TiagoTavares005/LCLP_DLog/README.md

# LCLP_DLog
Low Cost Low Power DataLogger
