TiagoTavares005/LCLP_DLog/PCB/Readme

Existem duas versões da PCB: Versão V7 que foi a usada como prova de conceito e a Versão revisionada já com os componentes corrigidos para fazer a produção
