TiagoTavares005/LCLP_DLog/firmware_datalogger_estudos/estudo_huffman/grafico_dispersao_pulsos.png

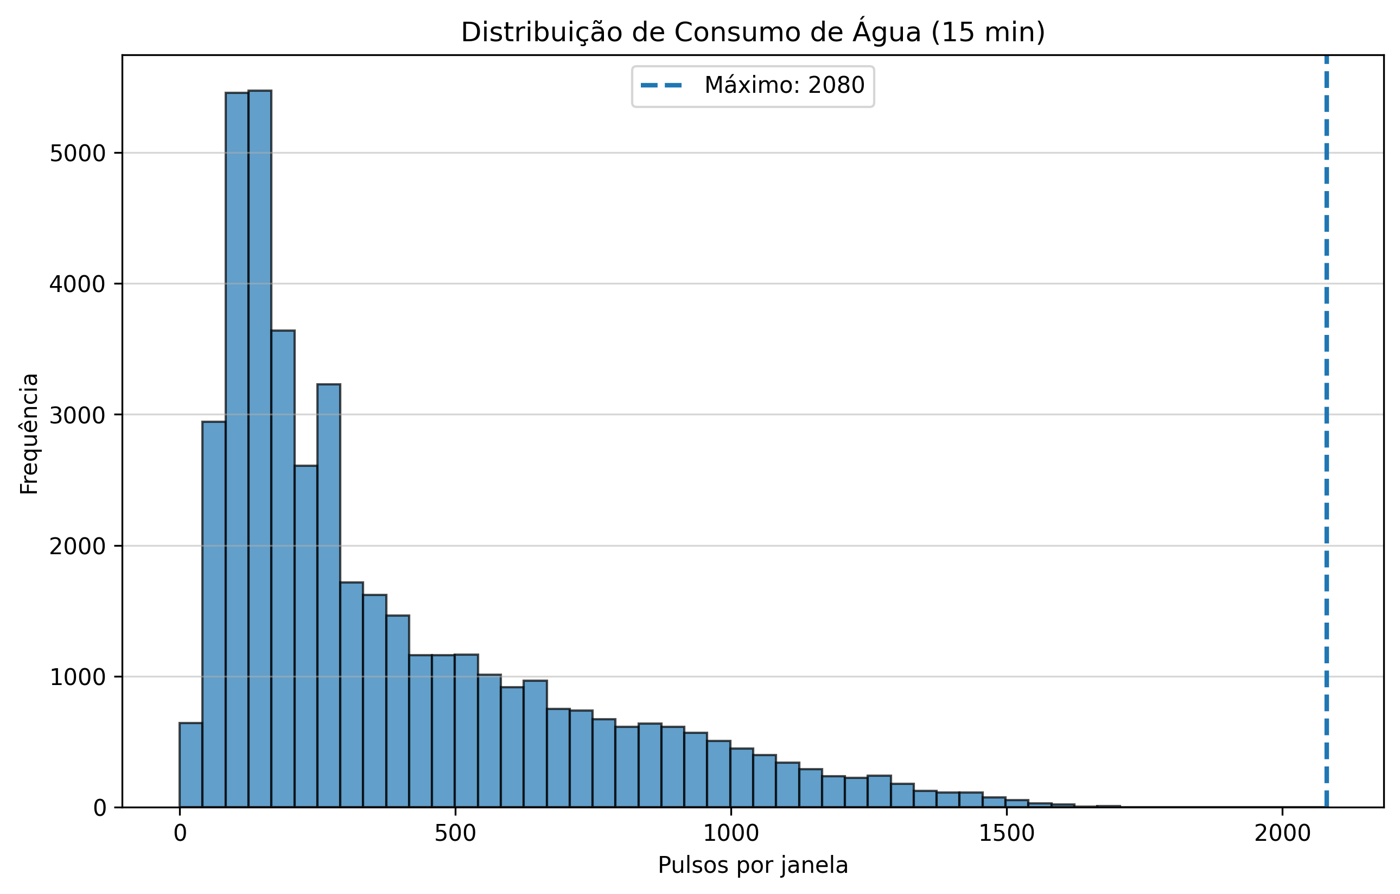
firmware_datalogger_estudos/estudo_huffman/grafico_dispersao_pulsos.png
