TiagoTavares005/LCLP_DLog/firmware_datalogger_estudos/estudo_sampls_ppk2/Analise_pulsos_datalogger/fig1_serie_temporal.png

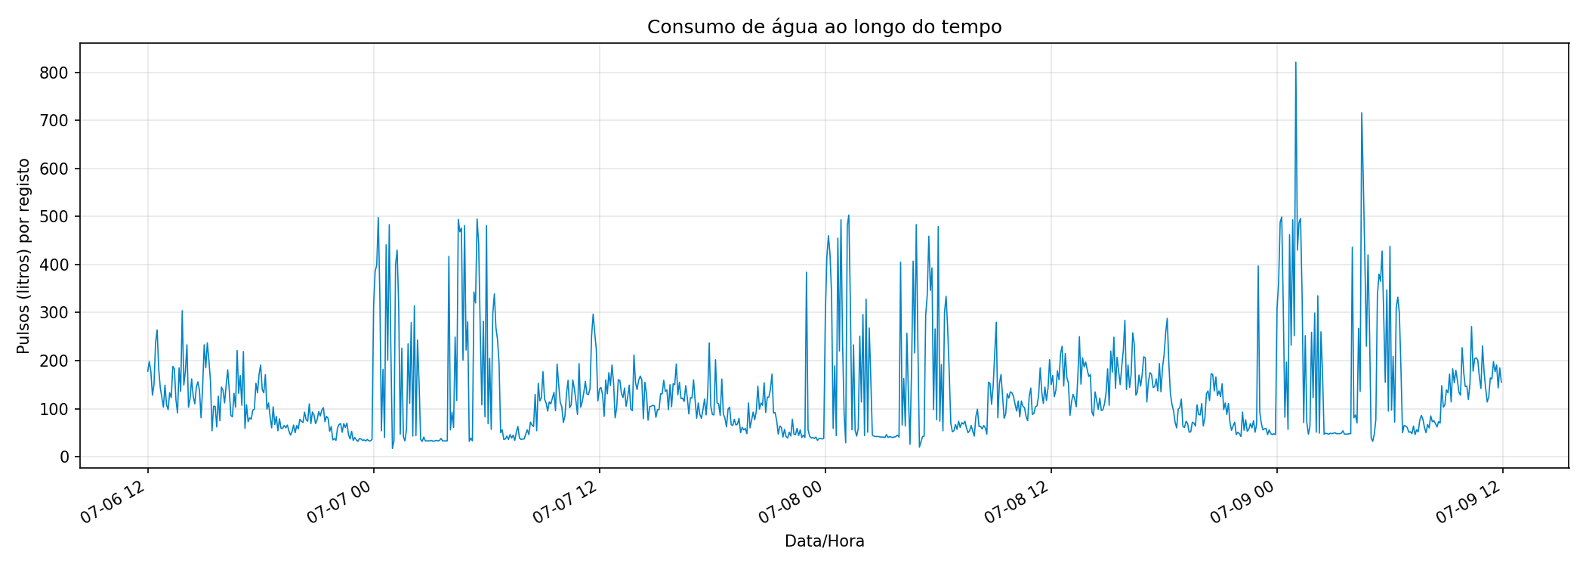
firmware_datalogger_estudos/estudo_sampls_ppk2/Analise_pulsos_datalogger/fig1_serie_temporal.png
