TiagoTavares005/LCLP_DLog/firmware_datalogger_estudos/estudo_sampls_ppk2/estudos_base_reais/consumos_1ksamp_2h10_sd1h_lora_2h_pcb/real_fig4_carga_acumulada.png

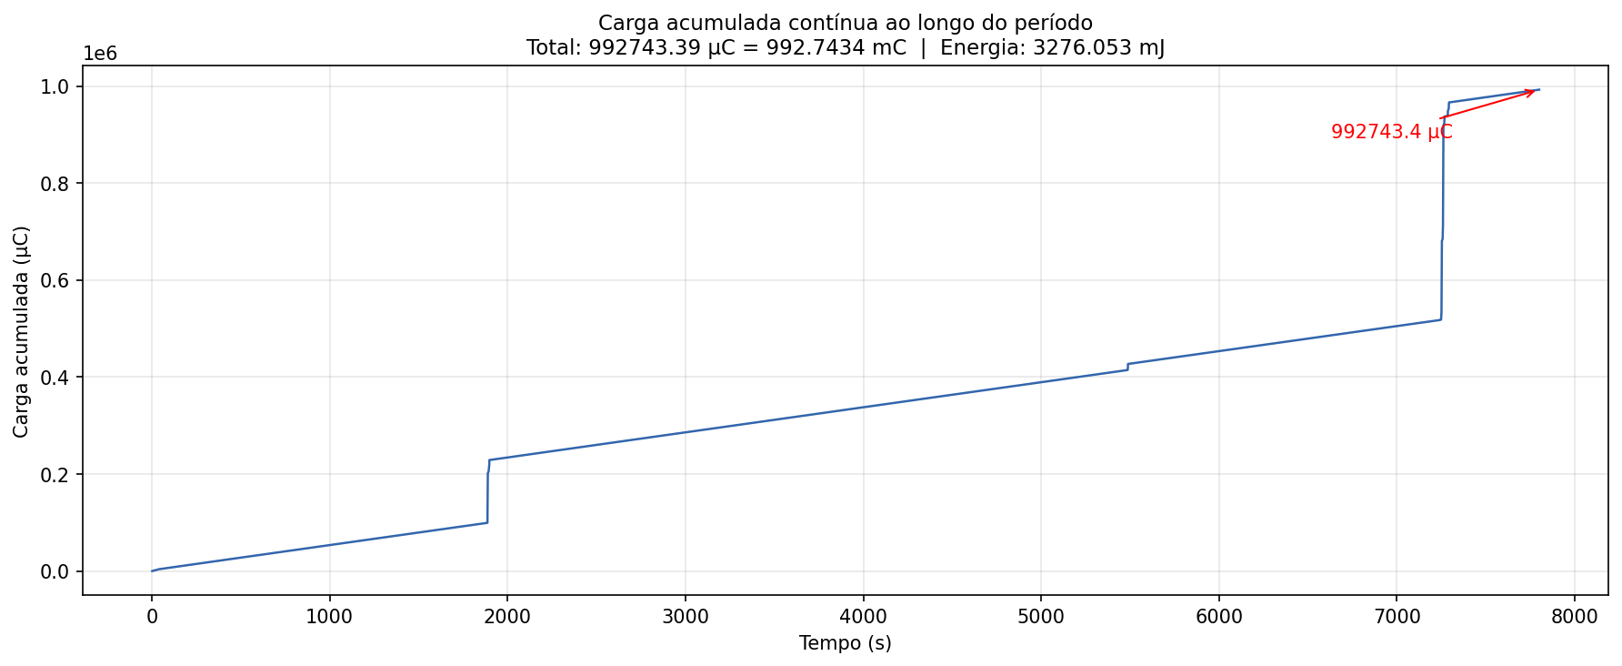
firmware_datalogger_estudos/estudo_sampls_ppk2/estudos_base_reais/consumos_1ksamp_2h10_sd1h_lora_2h_pcb/real_fig4_carga_acumulada.png
