TiagoTavares005/LCLP_DLog/firmware_datalogger_estudos/estudo_sampls_ppk2/fig1_overview_corrente.png

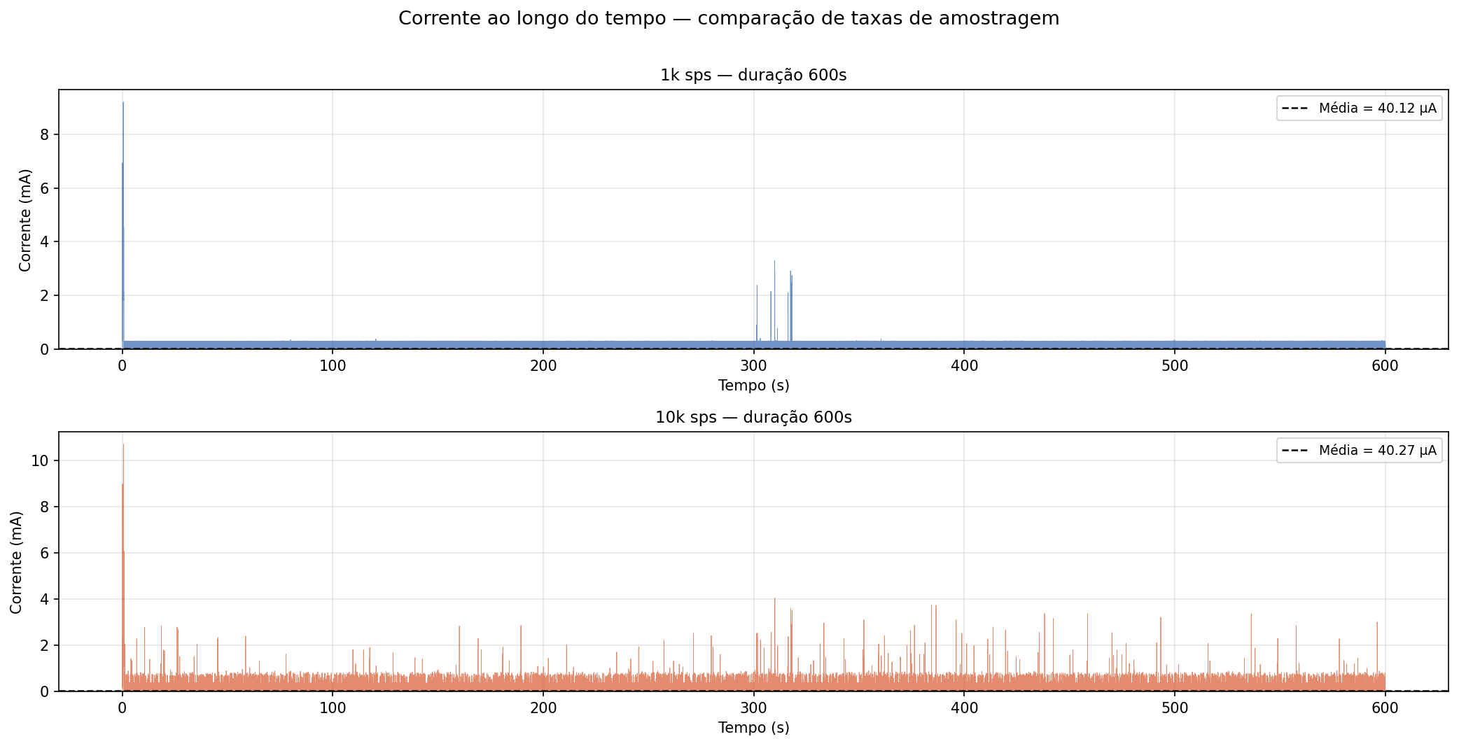
firmware_datalogger_estudos/estudo_sampls_ppk2/fig1_overview_corrente.png
