TiagoTavares005/LCLP_DLog/firmware_datalogger_estudos/estudo_sampls_ppk2/fig2_distribuicao.png

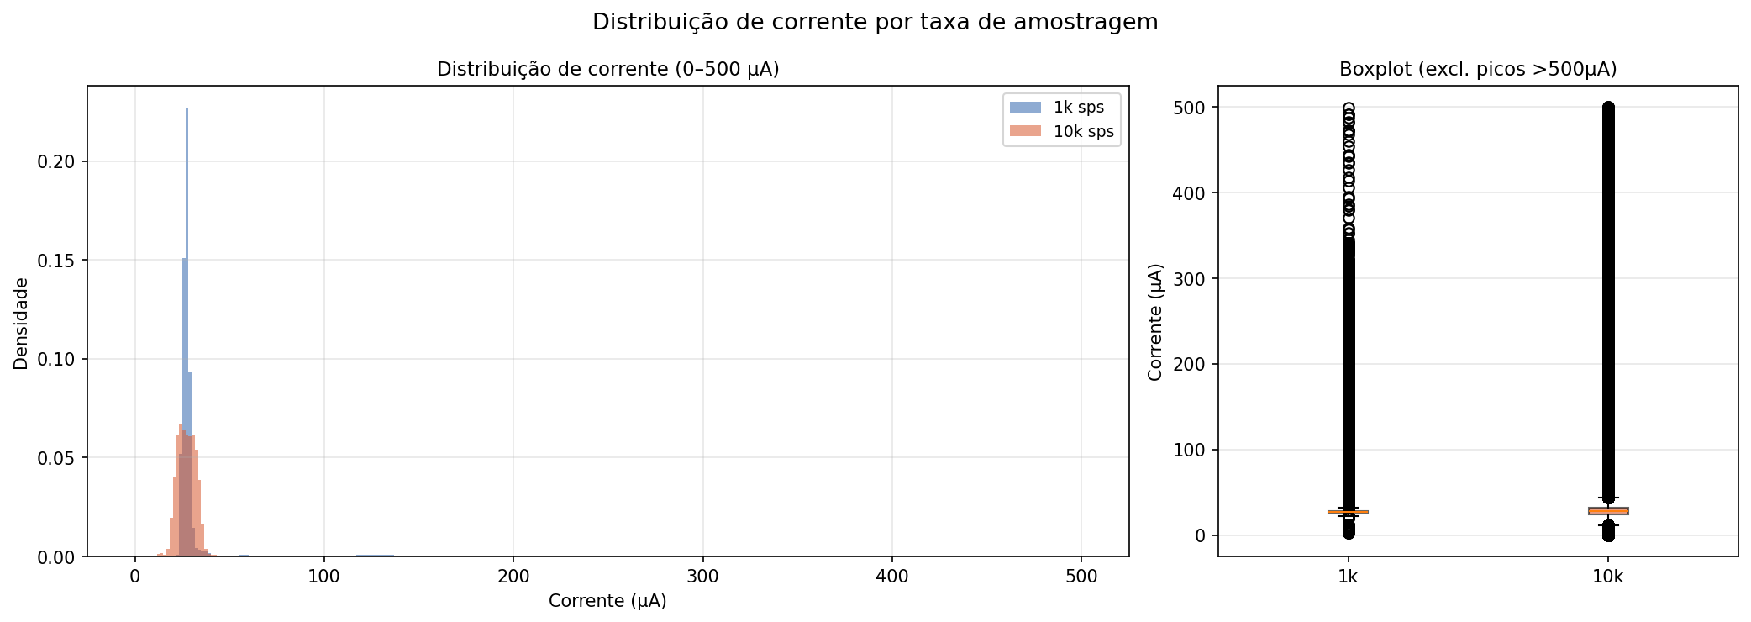
firmware_datalogger_estudos/estudo_sampls_ppk2/fig2_distribuicao.png
