TiagoTavares005/LCLP_DLog/firmware_datalogger_estudos/estudo_sampls_ppk2/fig3_zoom_pico.png

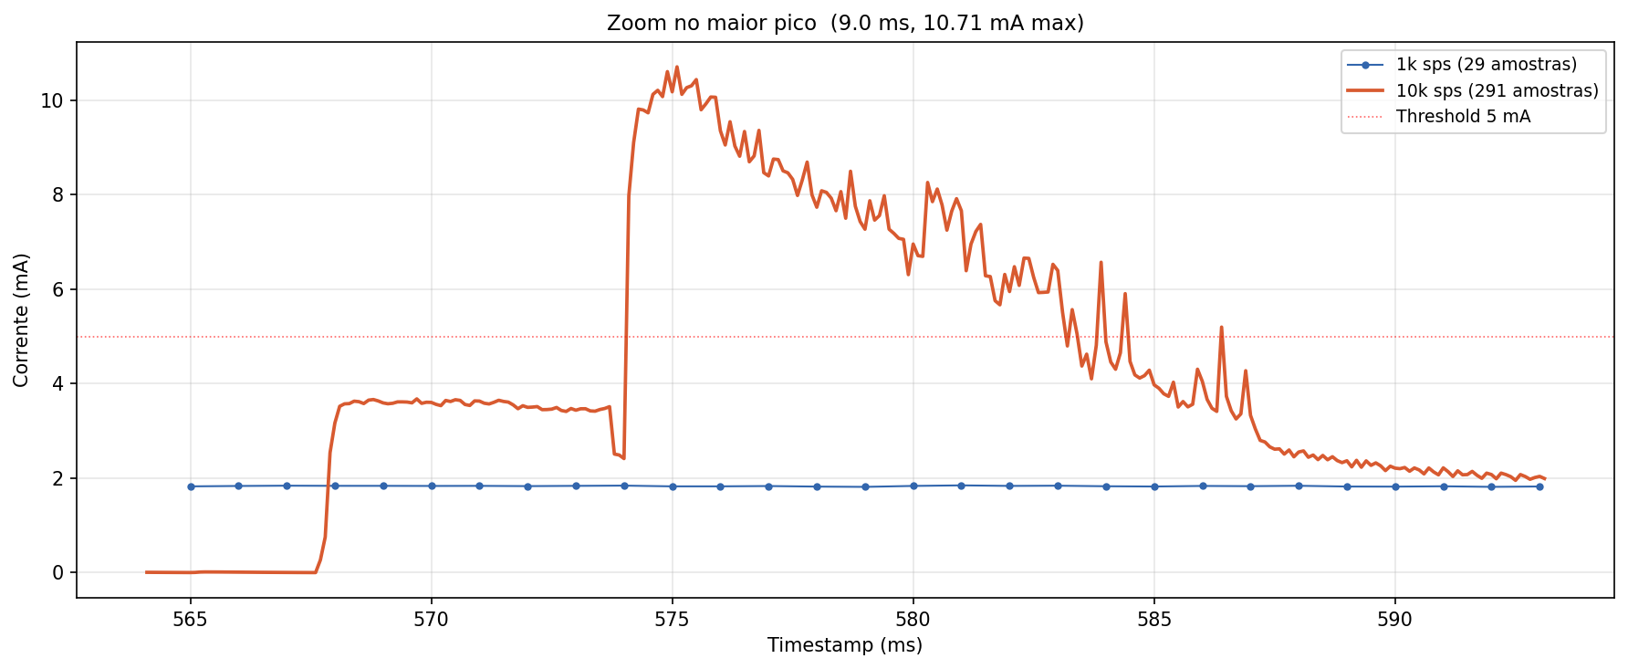
firmware_datalogger_estudos/estudo_sampls_ppk2/fig3_zoom_pico.png
