TiagoTavares005/LCLP_DLog/firmware_datalogger_estudos/estudo_sampls_ppk2/proj_fig2_decomposicao_energia.png

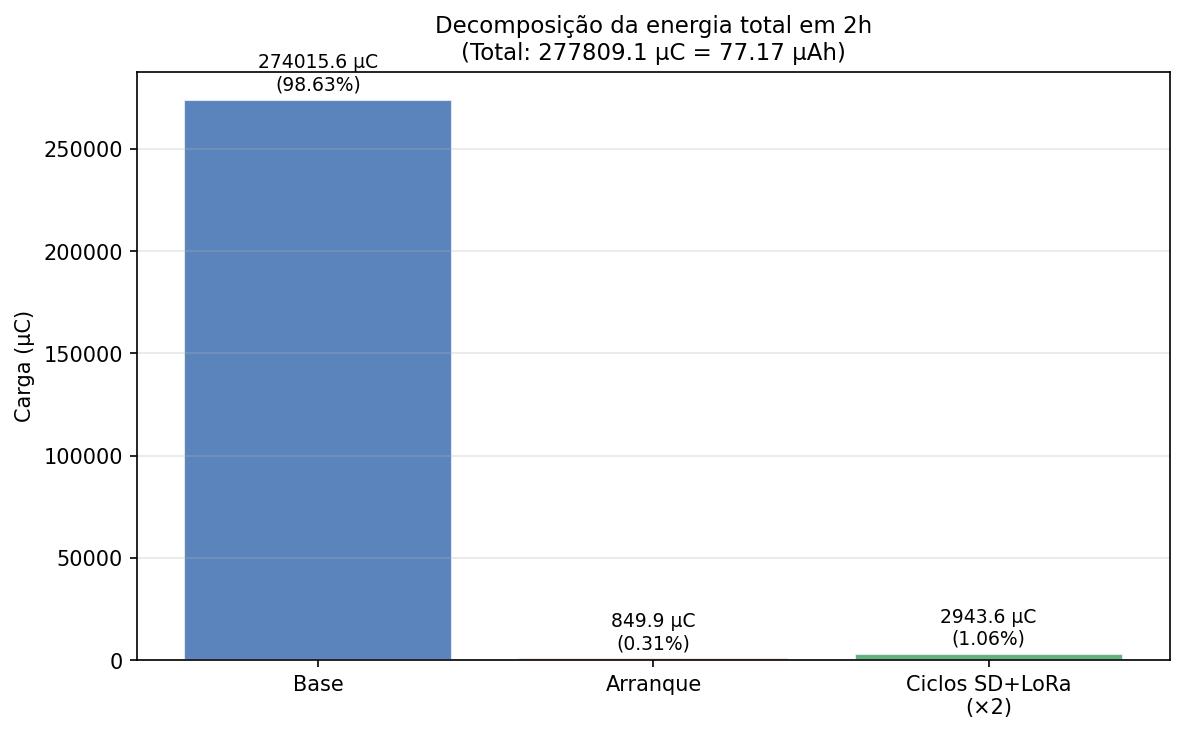
firmware_datalogger_estudos/estudo_sampls_ppk2/proj_fig2_decomposicao_energia.png
