TiagoTavares005/LCLP_DLog/firmware_datalogger_estudos/estudo_sampls_ppk2/proj_fig4_zoom_evento_sdlora.png

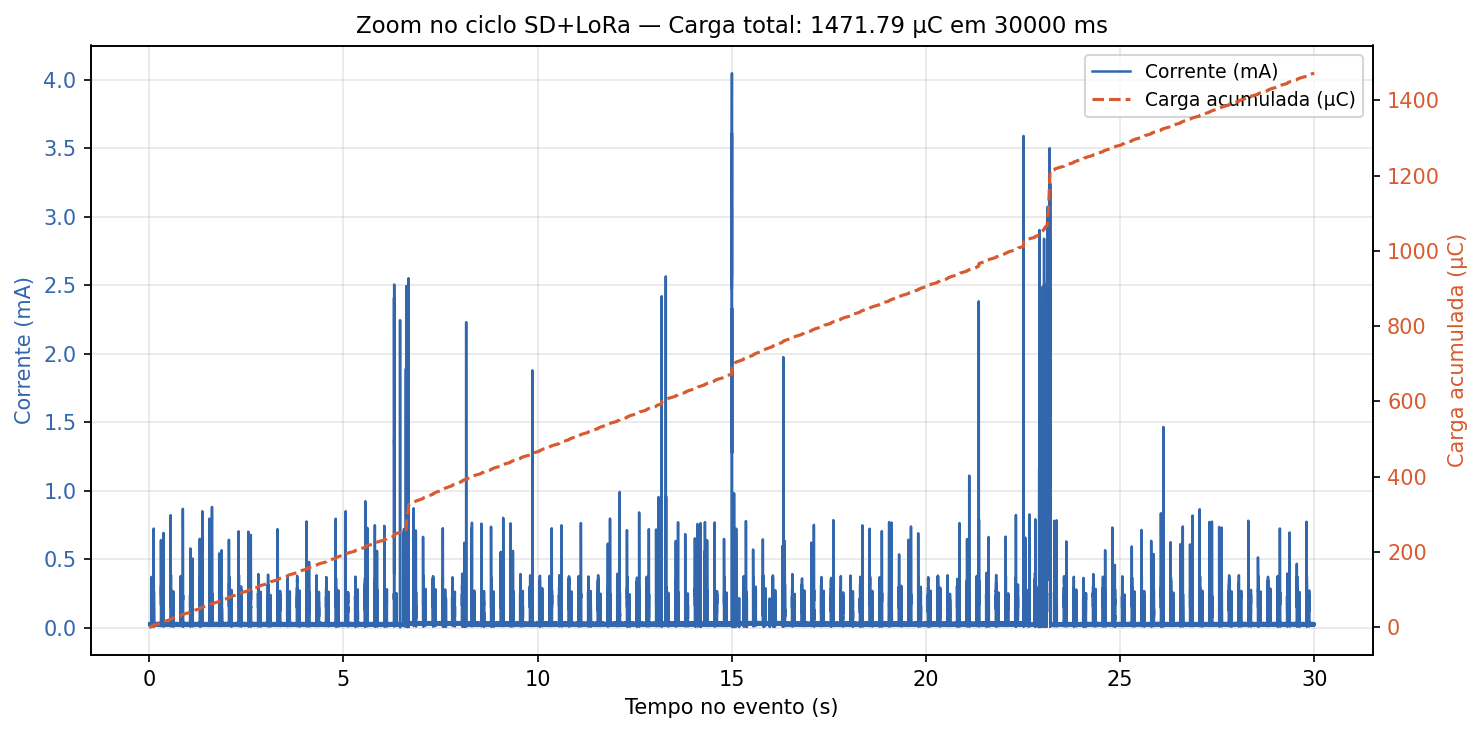
firmware_datalogger_estudos/estudo_sampls_ppk2/proj_fig4_zoom_evento_sdlora.png
