TiagoTavares005/LCLP_DLog/firmware_datalogger_estudos/estudo_sampls_ppk2/proj_fig1_perfil_componentes.png

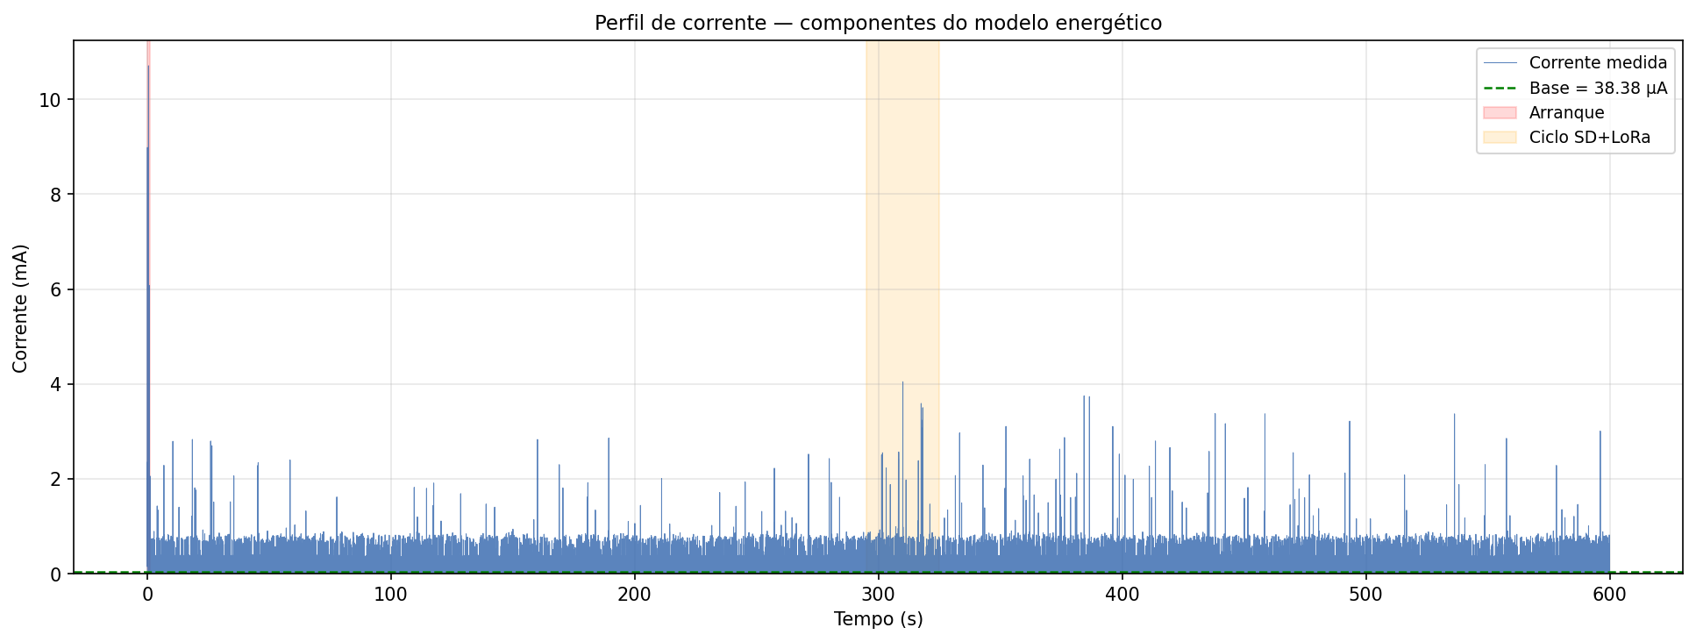
firmware_datalogger_estudos/estudo_sampls_ppk2/proj_fig1_perfil_componentes.png
