TiagoTavares005/LCLP_DLog/Firmware_LCLP/LCLP_Code/build/LCLP_Code_sysbuild_cache.txt

APPLICATION_BINARY_DIR:PATH=C:/Nordic/LCLP_Code/build
APPLICATION_SOURCE_DIR:PATH=C:/ncs/v3.1.1/zephyr/share/sysbuild/template
APP_DIR:PATH=c:/Nordic/LCLP_Code
BOARD_DIR:PATH=C:/Nordic/LCLP_Board/boards/LCLPGroup/LCLPv4
BOARD_DIRECTORIES:INTERNAL=C:/Nordic/LCLP_Board/boards/LCLPGroup/LCLPv4
BOARD_EXTENSIONS:BOOL=ON
BOARD_ROOT:PATH=C:/Nordic/LCLP_Board
CACHED_BOARD:STRING=LCLPv4/nrf54l15/cpuapp
CACHED_SHIELD:STRING=
CACHED_SNIPPET:STRING=
DEBUG_THREAD_INFO:UNINITIALIZED=Off
FIND_PACKAGE_MESSAGE_DETAILS_Python3:INTERNAL=[C:/ncs/toolchains/c1a76fddb2/opt/bin/python.exe][cfound components: Interpreter ][v3.12.4(3.10)]
HWM:INTERNAL=v2
HWMv2:INTERNAL=True
LCLP_Code_DEBUG_THREAD_INFO:UNINITIALIZED=Off
LCLP_Code_NCS_RUNNER_HEX:INTERNAL=C:/Nordic/LCLP_Code/build/merged.hex
WEST:INTERNAL=C:/ncs/toolchains/c1a76fddb2/opt/bin/python.exe;-m;west
WEST_PYTHON:UNINITIALIZED=C:/ncs/toolchains/c1a76fddb2/opt/bin/python.exe
ZEPHYR_BASE:PATH=C:/ncs/v3.1.1/zephyr
Zephyr_DIR:PATH=C:/ncs/v3.1.1/zephyr/share/zephyr-package/cmake
_Python3_EXECUTABLE:INTERNAL=C:/ncs/toolchains/c1a76fddb2/opt/bin/python.exe
_Python3_INTERPRETER_PROPERTIES:INTERNAL=Python;3;12;4;64;;cp312-win_amd64;C:\ncs\toolchains\c1a76fddb2\opt\bin\Lib;C:\ncs\toolchains\c1a76fddb2\opt\bin\Lib;C:\ncs\toolchains\c1a76fddb2\opt\bin\Lib\site-packages;C:\ncs\toolchains\c1a76fddb2\opt\bin\Lib\site-packages
_Python3_INTERPRETER_SIGNATURE:INTERNAL=ad3ffb19b94fc4f71ea7dd70ebcbd448
sysbuild_toplevel_BINARY_DIR:STATIC=C:/Nordic/LCLP_Code/build
sysbuild_toplevel_IS_TOP_LEVEL:STATIC=ON
sysbuild_toplevel_SOURCE_DIR:STATIC=C:/ncs/v3.1.1/zephyr/share/sysbuild
BOARD:STRING=LCLPv4/nrf54l15/cpuapp
SYSBUILD_NAME:STRING=LCLP_Code
SYSBUILD_MAIN_APP:BOOL=True
