TiagoTavares005/LCLP_DLog/Firmware_LCLP/LCLP_Code/build/LCLP_Code/sysbuild_modules.txt

"nrf":"C:/ncs/v3.1.1/nrf":"C:/ncs/v3.1.1/nrf/sysbuild"
"mcuboot":"C:/ncs/v3.1.1/bootloader/mcuboot":"C:/ncs/v3.1.1/bootloader/mcuboot/boot/zephyr/sysbuild"
