TiagoTavares005/LCLP_DLog/Firmware_LCLP/LCLP_Code/build/LCLP_Code/zephyr_settings.txt

# WARNING. THIS FILE IS AUTO-GENERATED. DO NOT MODIFY!
#
# This file contains build system settings derived from your modules.
#
# Modules may be set via ZEPHYR_MODULES, ZEPHYR_EXTRA_MODULES,
# and/or the west manifest file.
#
# See the Modules guide for more information.
"BOARD_ROOT":"C:/ncs/v3.1.1/nrf"
"DTS_ROOT":"C:/ncs/v3.1.1/nrf"
"SNIPPET_ROOT":"C:/ncs/v3.1.1/nrf"
"SOC_ROOT":"C:/ncs/v3.1.1/nrf"
"MODULE_EXT_ROOT":"C:/ncs/v3.1.1/nrf"
