TiagoTavares005/LCLP_DLog/firmware_datalogger_estudos/estudo_sampls_ppk2/Analise_pulsos_datalogger/fig2_consumo_diario.png

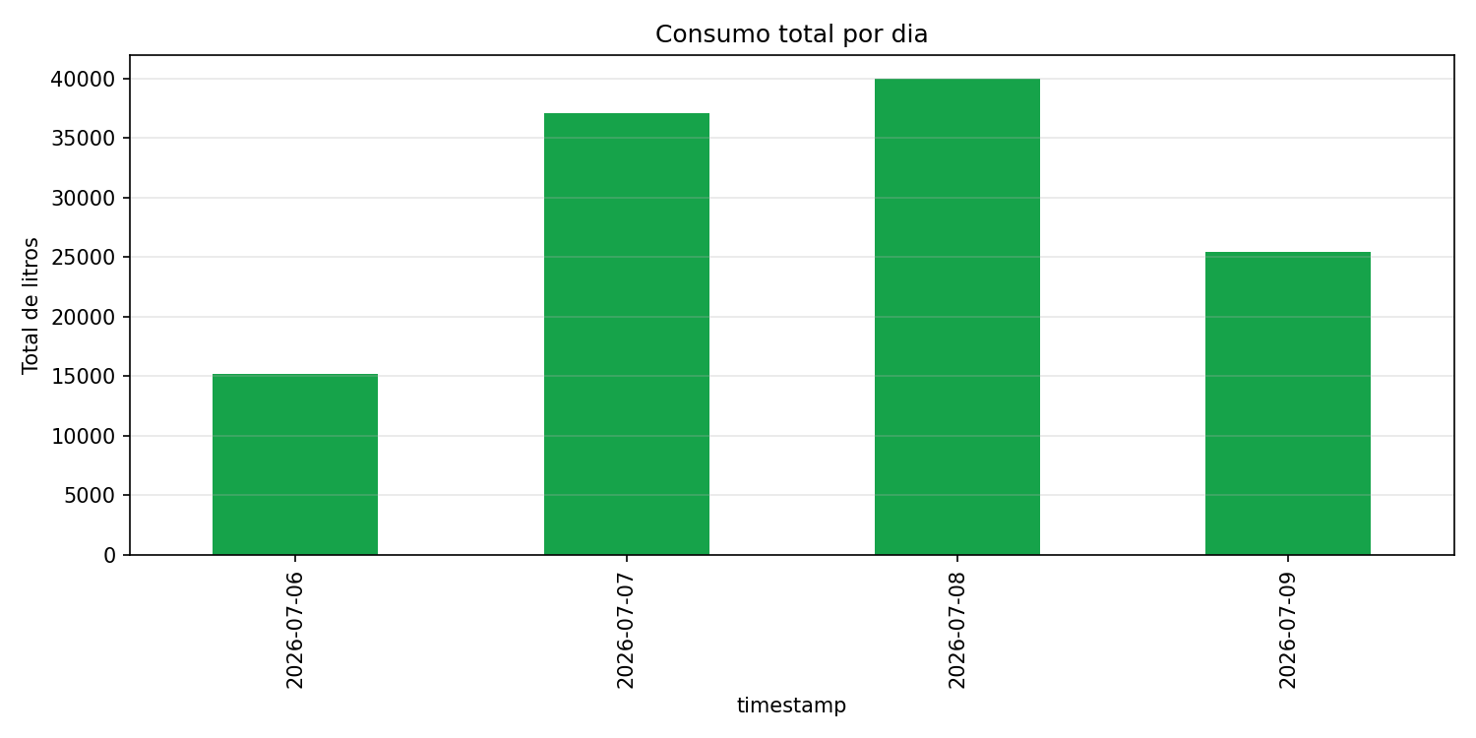
firmware_datalogger_estudos/estudo_sampls_ppk2/Analise_pulsos_datalogger/fig2_consumo_diario.png
