TiagoTavares005/LCLP_DLog/PCB/PCBV7/LCLP_DLog_V7.pdf

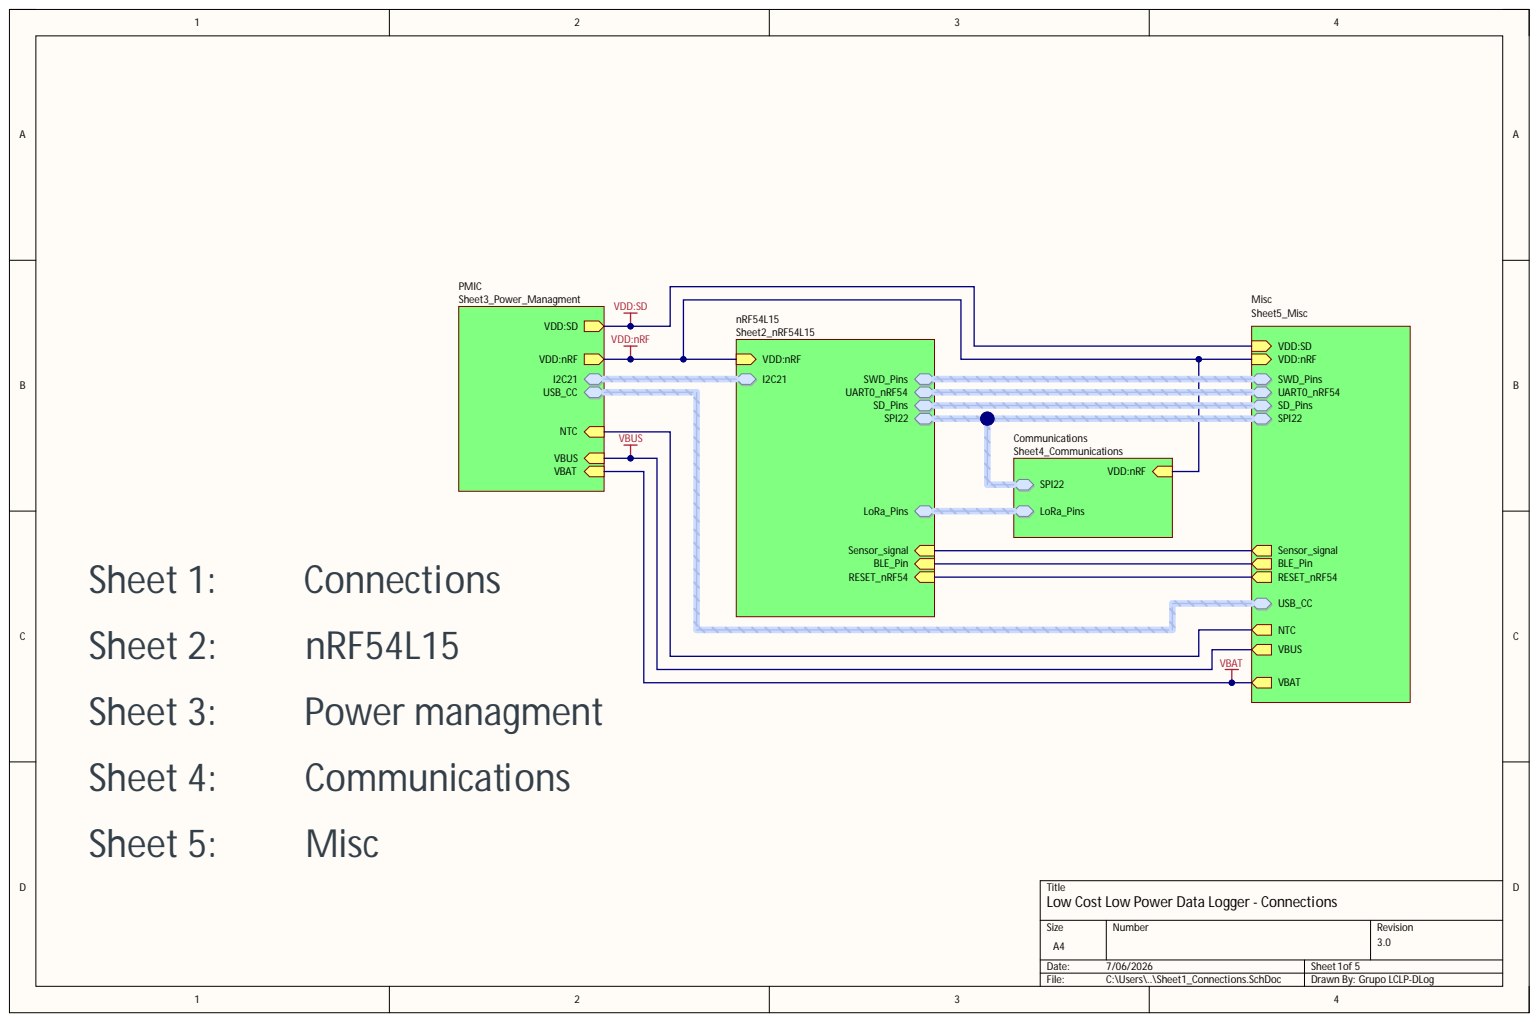
[picture p20: page 1]

Title
Low Cost Low Power Data Logger - Connections

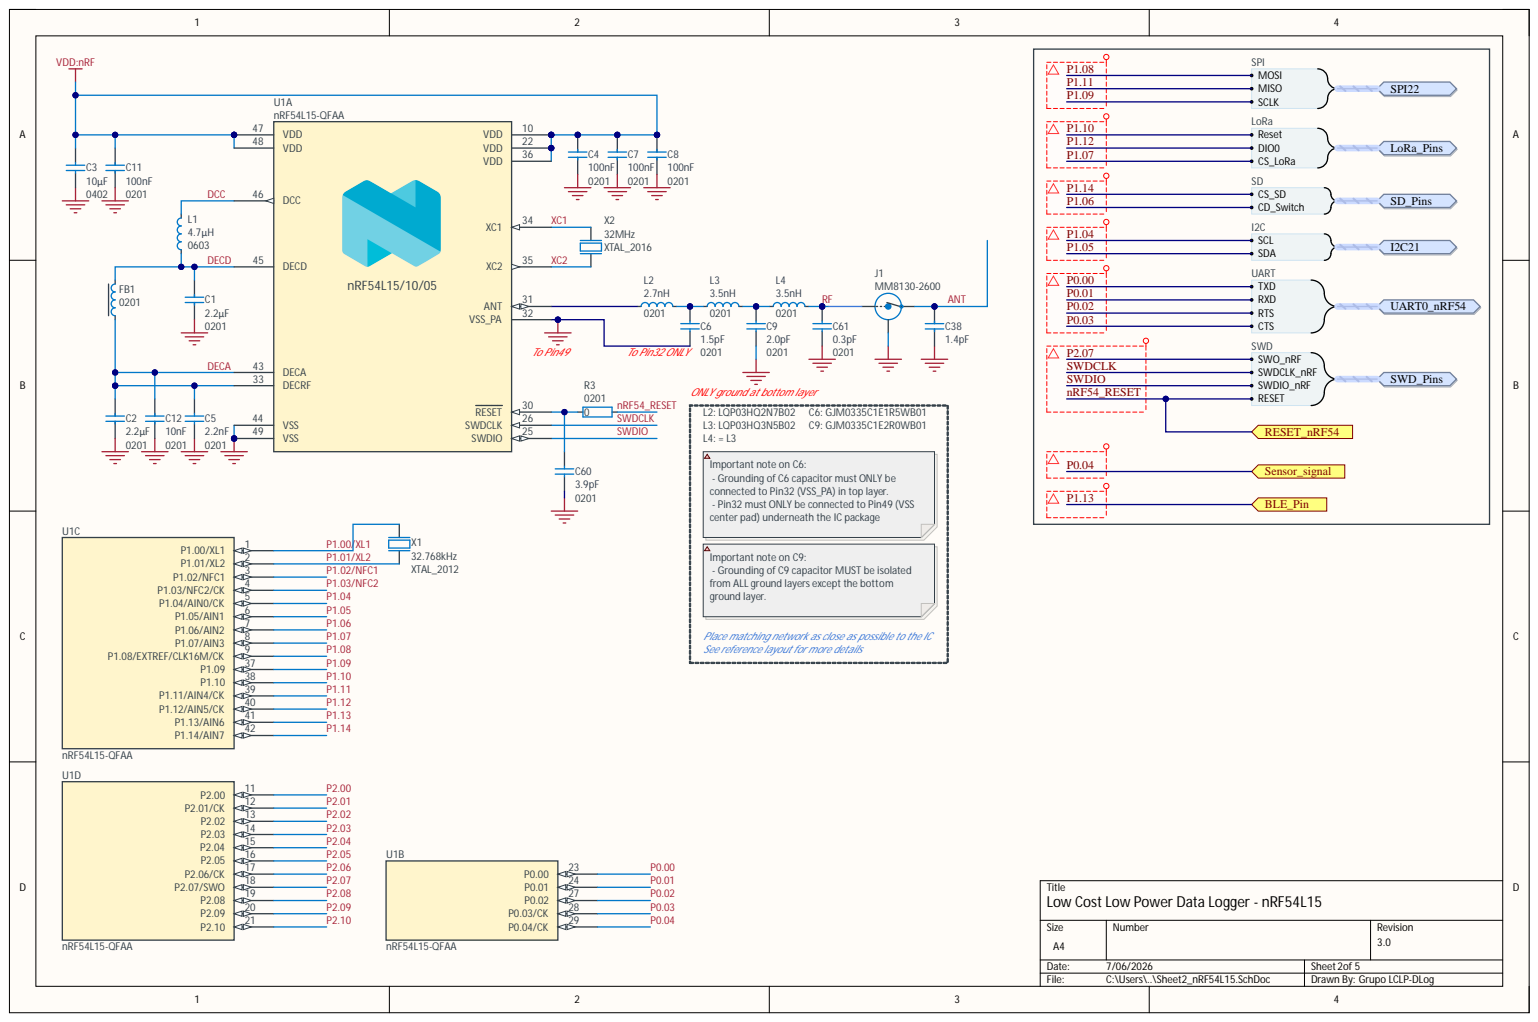
[picture p21: page 2]

DECA 43
DECRF 33

Important note on C6:
- Grounding of C6 capacitor must ONLY be
connected to Pin32 (VSS_PA) in top layer.
- Pin32 must ONLY be connected to Pin49 (VSS
center pad) underneath the IC package

Important note on C9:
- Grounding of C9 capacitor MUST be isola
from ALL ground layers except the bottom
ground layer.

Place matching network as close as possible to the IC
See reference layout for more details

Low Cost Low Power Da

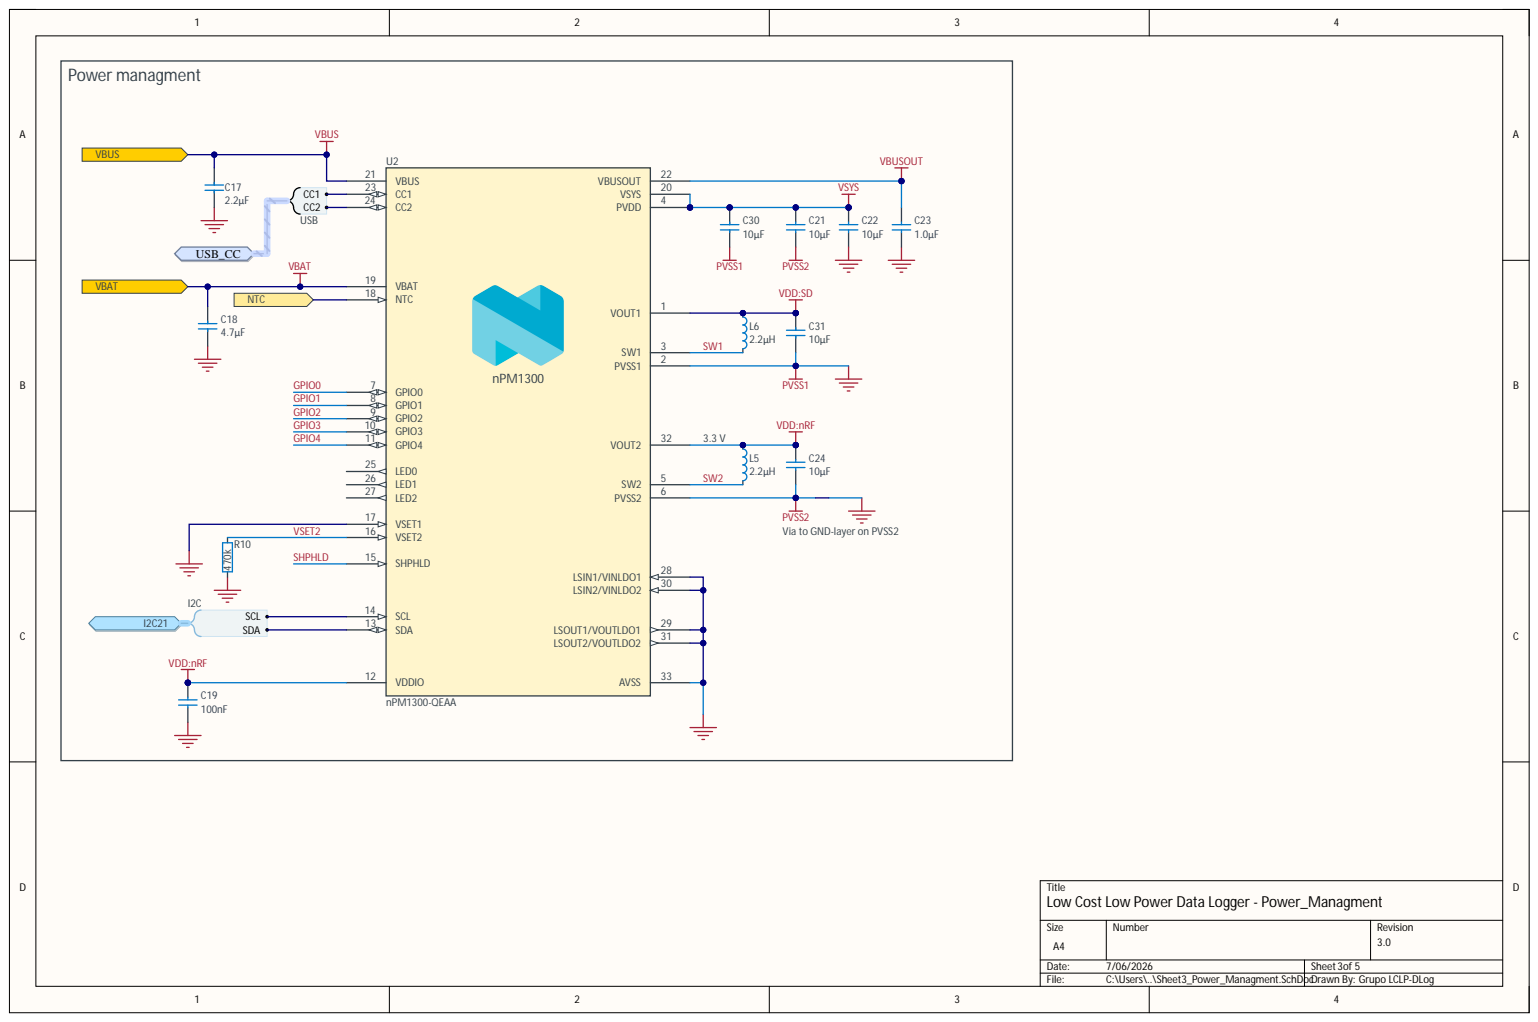
[picture p22: page 3]

VBAT | CC1 23 | VSYS

PVSS2
Via to GND-layer on PVSS2

VSET 2

Low Cost Low Power Da

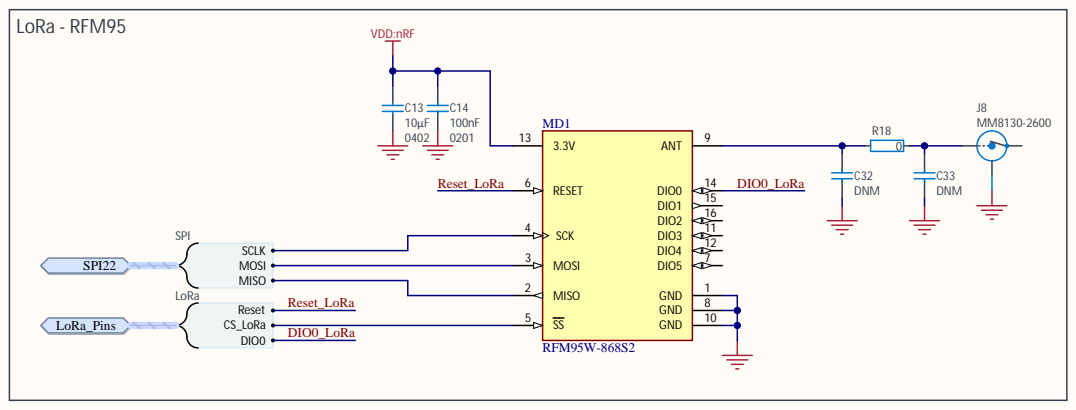
[picture p23: page 4]

Low Cost Low Power Da

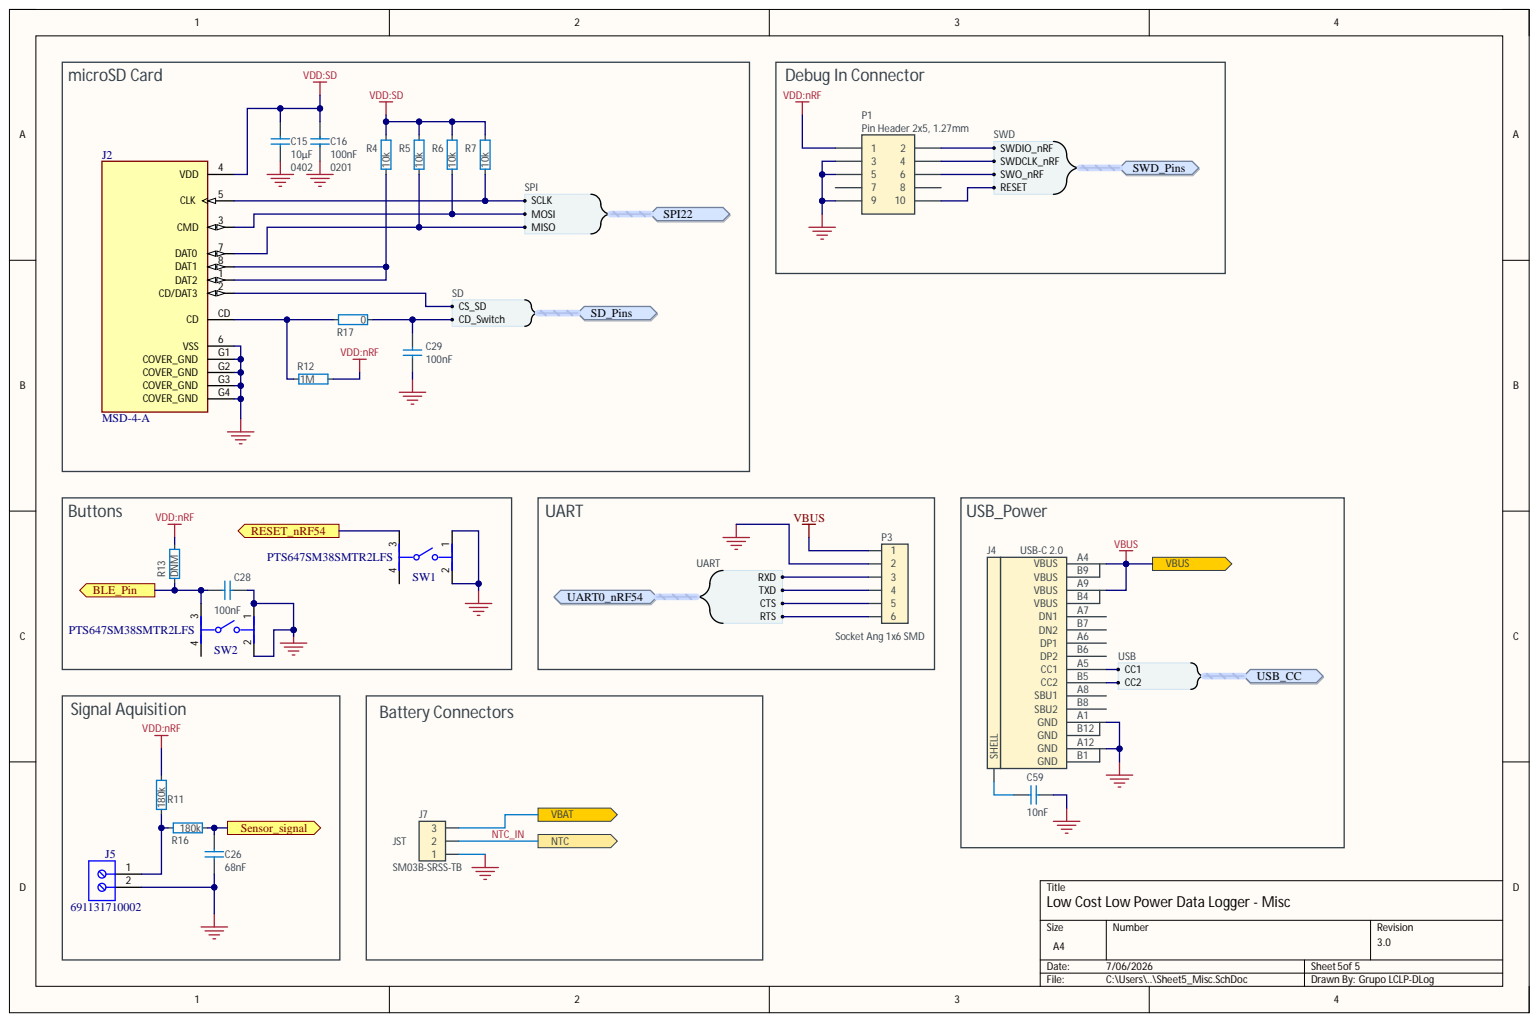
[picture p24: page 5]

Title
Low Cost Low Power Data Logger - Misc

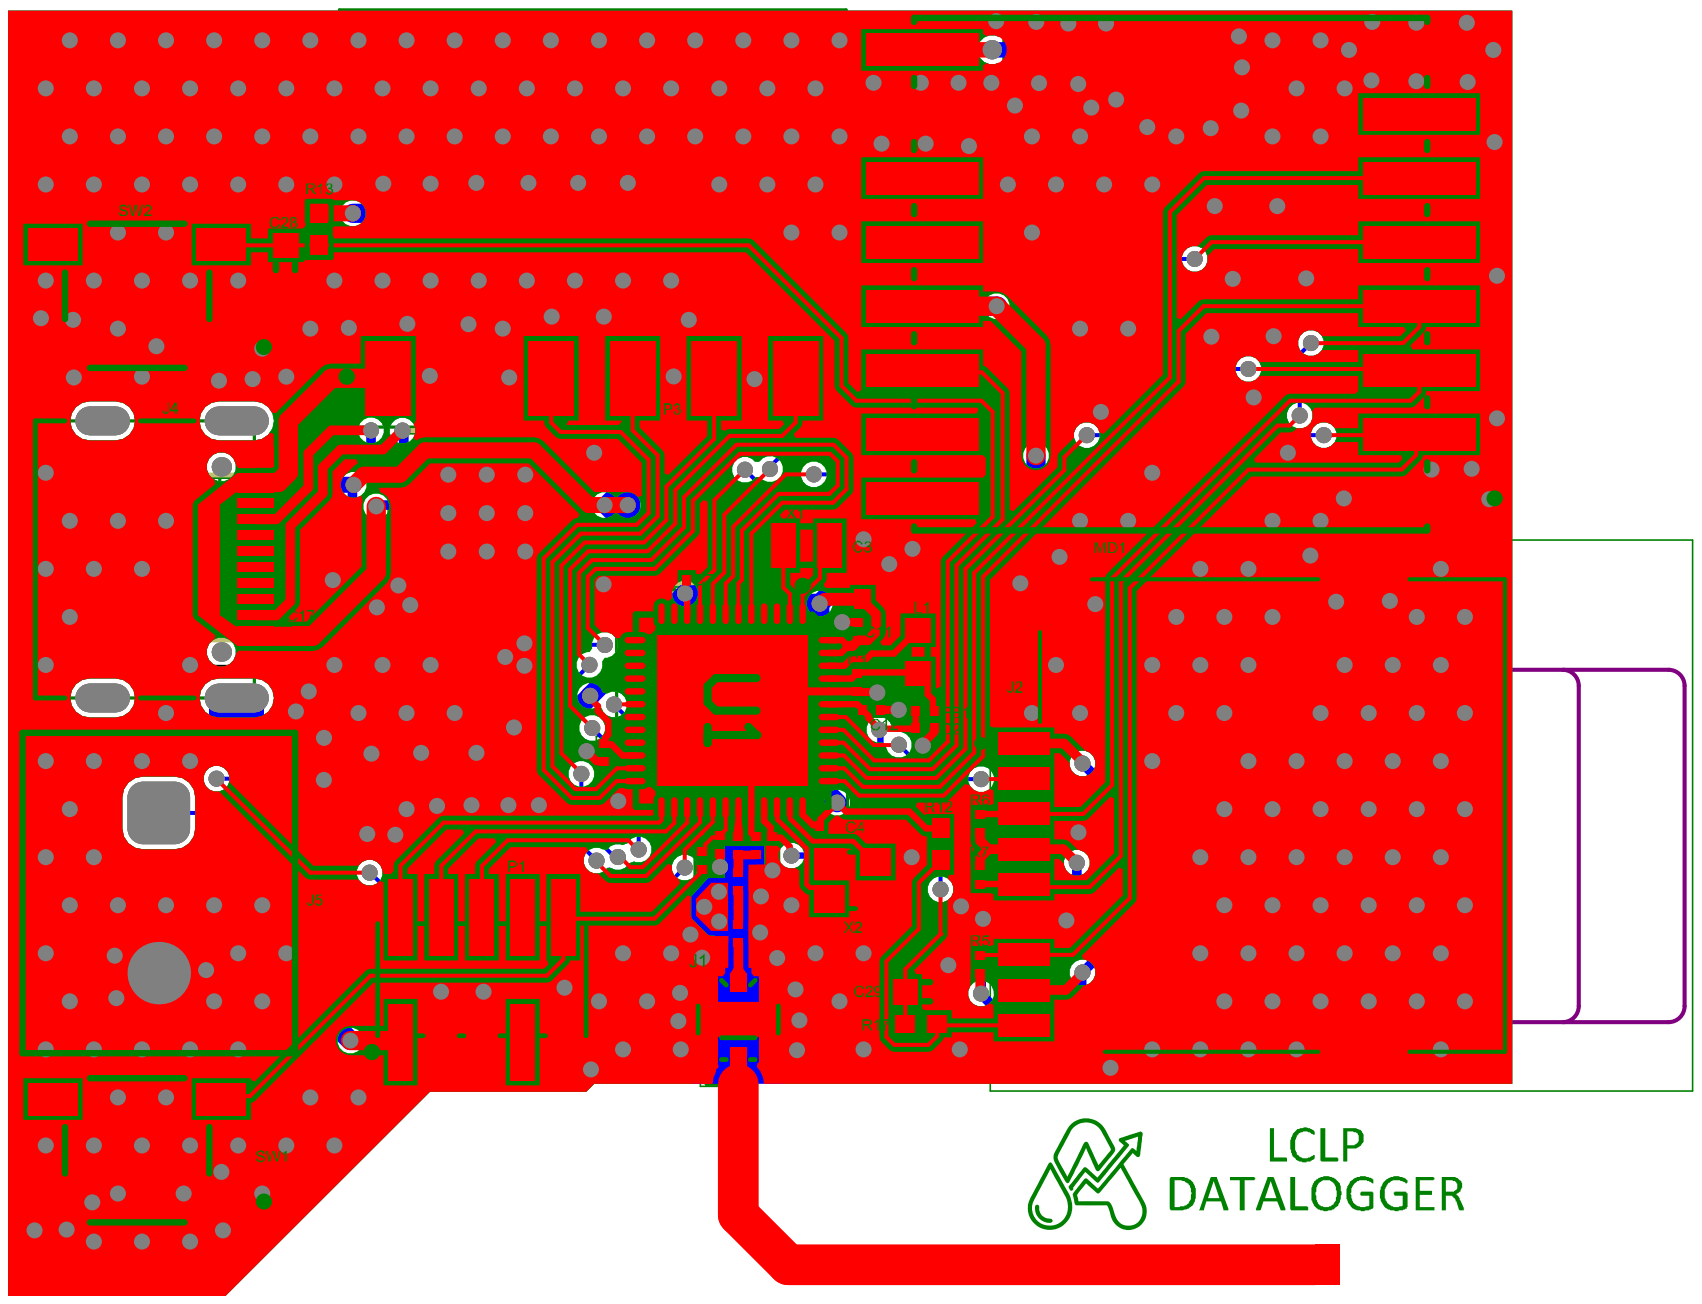
[picture p25: page 6]

Line# | Name | Description | Designator | Revision ID | Revision Status | Quantity | Manufacturer 1 | Manufacturer Part Number 1 | Manufacturer Lifecycle1 | Supplier 1 | Supplier Part Number 1 | Supplier Unit Price1 | Supplier Subtotal 1
| 2.2µF | Capacitor, Ceramic, 2.2µF 2.5VX6T0201,±20% | C1, C2 | | | 2 Murata | | GRM033D80E225ME47D | VolumeProduction | Mouser | 81-GRM033D80E225ME7D | 0.12 | 0.24
| 10µF | Capacitor, X6S, ±20%, 6.3V | C3, C13, C15 | | | 3 | | | | N.A. | N.A.
| 100nF | Capacitor, X7R, ±10% | C4, C7, C8, C11, C14, C16 | | | 6 | | | | N.A. | N.A.
| 2.2nF | Capacitor, X7R, ±10%, 10V | C5 | | | 1 | | | | N.A. | N.A.
| 1.5pF | Capacitor, NP0, ±0.05pF, 25V, High Q | C6 | | | 1 Murata | | GJM0335C1E1R5WB01D | VolumeProduction | Mouser | 81-GJM0335C1E1R5WB1D | 0.11 | 0.11
| 2.0pF | Capacitor, NP0, ±0.05pF, 25V C9 | | | | 1 | | | | N.A. | N.A.
| 10nF | Capacitor, X7R, 6.3V | C12 | | | 1 Murata | | GRM033R70J103KA01D | VolumeProduction | Digi-Key | 490-1262-1-ND
| 2.2µF | Capacitor, X5R, ±10% | C17 | | | 1 | | | | Digi-Key | 490-10451-1-ND
| 4.7µF | Capacitor, Ceramic, X5R, ±10%, 10V | C18 | | | 1 | | | | N.A. | N.A.
| 100nF | Capacitor, X5R, ±10%, 100nF, 16V | C19 | | | 1 | | | | N.A. | N.A.
| 10µF | Capacitor, X5R, ±20% | C21, C22, C24 | | | 3 | | | | N.A. | N.A.
| 1.0µF | Capacitor, Ceramic, 1.0µF 10VX5R0603,±10% | C23 | | | 1 | | | | N.A. | N.A.
| 68nF | Capacitor, X5R, ±20% | C26 | | | 1 | | | | N.A. | N.A.
| 100nF | Capacitor, X5R, ±20% | C28, C29 | | | 2 | | | | N.A. | N.A.
| 10µF | Capacitor, Ceramic, X5R, ±20%, 25V | C30, C31 | | | 2 Murata | | GRM188R61E106MA73J | VolumeProduction | Mouser | 81-GRM188R61E106MA3J | 0.26 | 0.52
| DNM | Capacitor, X5R, ±10% | C32, C33 | | | 2 | | | | Digi-Key | 490-10451-1-ND
| 1.4pF | Capacitor, C0G, ±0.05pF, 25V C38 | | | | 1 Murata | | GJM0335C1E1R4WB01D | VolumeProduction | Mouser | 81-GJM0335C1E1R4WB1D | 0.1 | 0.1
| 10nF | Capacitor, X7R, ±10%, 100V | C59 | | | 1 Murata | | GCM188R72A103KA37D | VolumeProduction | DigiKey | 490-4781-1-ND | 0.1 | 0.1
| 3.9pF | Chip Cap 0201 | C60 | | | 1 | | | | N.A. | N.A.
| 0.3pF | Capacitor, C0G, ±0.1pF, 50V | C61 | | | 1 Murata | | GRM0335C1HR30BA01D | VolumeProduction | DigiKey | 490-6135-2-ND | 0.00326 | 48.9
| 120R/0.2A | FerriteBead, 120Ohm@ 100MHz, 200mA, 500mOhm Max | FB1 | | | 1 Murata | | BLM03AX121SN1D | VolumeProduction | DigiKey | 490-5622-1-ND | 0.1 | 0.1
| MM8130-2600 | Coaxial Connector with Switch | J1, J8 | | | 2 Murata | | MM8130-2600RA2 | VolumeProduction | DigiKey | 490-4981-1-ND | 0.31 | 0.62
| MSD-4-A | Micro SDCard Connector, 9 Positions, Connector and Ejector, Push In, Auto Eject Out, SurfaceMount, 1.8mm Height AboveBoard, Gold Flash | J2 | | | 1
| USB-C2.0 | USB-CReceptacle, 16Pin, USB2.0 | J4 | | | 1 | | | | Cabcon | SD-80259-1021
| 691131710002 | Terminal Block, 5MMPitch, Horizontal, Pressure Clamp, 30-12AWG, 2Pins, Gry | J5 | | | 1 Wurth Elektronik | | 691131710002 | VolumeProduction
| HDR-3, 1mm | 1.0mm pitch connector side entrySMD | J7 | | | 1 | | | | Cabcon | SM03B-SRSS-TB(LF)(SN)
| 4.7µH | Inductor, 120mA, ±20%, 0.65R | L1 | | | 1 TDK | | MLZ1608M4R7WT000 | VolumeProduction | Mouser | 810-MLZ1608M4R7WT000 | 0.1 | 0.1
| 2.7nH | Inductor, 600mA, ±0.1ｎH, 120mOhm | L2 | | | 1 Murata | | LQP03HQ2N7B02D | VolumeProduction | DigiKey | 490-13909-1-ND | 0.13 | 0.13
| 3.5nH | Inductor, 500mA, ±0.1ｎH, 170mOhm | L3, L4 | | | 2 Murata | | LQP03HQ3N5B02D | VolumeProduction | DigiKey | 490-13925-1-ND | 0.13 | 0.26
| 2.2µH | Inductor, Irms=2.5A, Isat=2.9A, ±20%, DCR=73mΩ | L5, L6 | | | 2 SamsungElectro- | Mechanics | CIGT201610EH2R2MNE | VolumeProduction | DigiKey | 1276-6901-1-ND | 0.19 | 0.38
| RFM95W-868S2 | RFM95WLoRATransceiver Module868MHz | MD1 | | | 1 RFSolutions | | RFM95W-868S2
| Pin Header 2x5, 1.27mm | Pin Header 2x5, 1.27mm (50mil), SMD, KeyingShroud | P1 | | | 1 | | | | Cabcon | 3132-10MS0BK00R5
| Socket Ang1x6 SMD | Socket 1x6, 2.54mm (100mil), Right Angled, SMD | P3 | | | 1 W-CON | | 2185-106ZS0CYNRX
| 0 | Resistor, ±1%, 0.05W | R3, R17, R18 | | | 3 | | | | N.A. | N.A.
| 10k | Resistor, ±1%, 0.05W | R4, R5, R6, R7 | | | 4 | | | | N.A. | N.A.
| 470k | Resistor, ±1%, 0.05W | R10 | | | 1 | | | | N.A. | N.A.
| 180k | Not mounted | R11 | | | 1 | | | | N.A. | N.A.
| 1M | Resistor, ±1%, 0.05W | R12 | | | 1 | | | | N.A. | N.A.
| DNM | Not mounted | R13 | | | 1 | | | | N.A. | N.A.
| 180k | Resistor, ±1%, 0.05W | R16 | | | 1 | | | | N.A. | N.A.
| PTS647SM38SMTR2 LFS | Switch TactileOFFMom SPSTRound Button Gull Wing50mA12VDC 100000Cycles 1.77N Surface Mount T/R | SW1, SW2 | | | 2 C&KComponents | | PTS647SM38SMTR2LFS
| nRF54L15-QFAA | Multi-protocol Bluetooth Low Energy, IEEE802.15.4 and 2.4GHzproprietary Wireless MCU | U1 | | | 1 | | | | NordicSemiconductor | nRF54L15-QFAA
| nRF54L15-QFAA | Multi-protocol Bluetooth Low Energy, IEEE802.15.4 and 2.4GHzproprietary Wireless MCU | U1 | | | 1 | | | | NordicSemiconductor | nRF54L15-QFAAC00
| nPM1300-QEAA | Li-Ion/Li-Polymer USB-C battery charger with high efficiencybuck regulators, LDOs or load switches, LED drivers, TWI and VBUSOUT | U2 | | | 1 | | | | NordicSemiconductor | nPM1300-QEAA
| 32.768kHz | XTALSMD2012, 32.768kHz, 9pF, ±20ppm | X1 | | | 1 TXC | | 9HT11-32.768KDZC-T | VolumeProduction | DigiKey | 887-1426-2-ND | 0.50413 | 1512.39
| 32MHz | XTALSMD2016, 32MHz, Cl=8pF, Tot: ±40ppm | X2 | | | 1 | | | | Digi-Key | 1253-1586-1-ND
