TiagoTavares005/LCLP_DLog/PCB/PCB_Revisionada/LCLP_DLog_V8.pdf

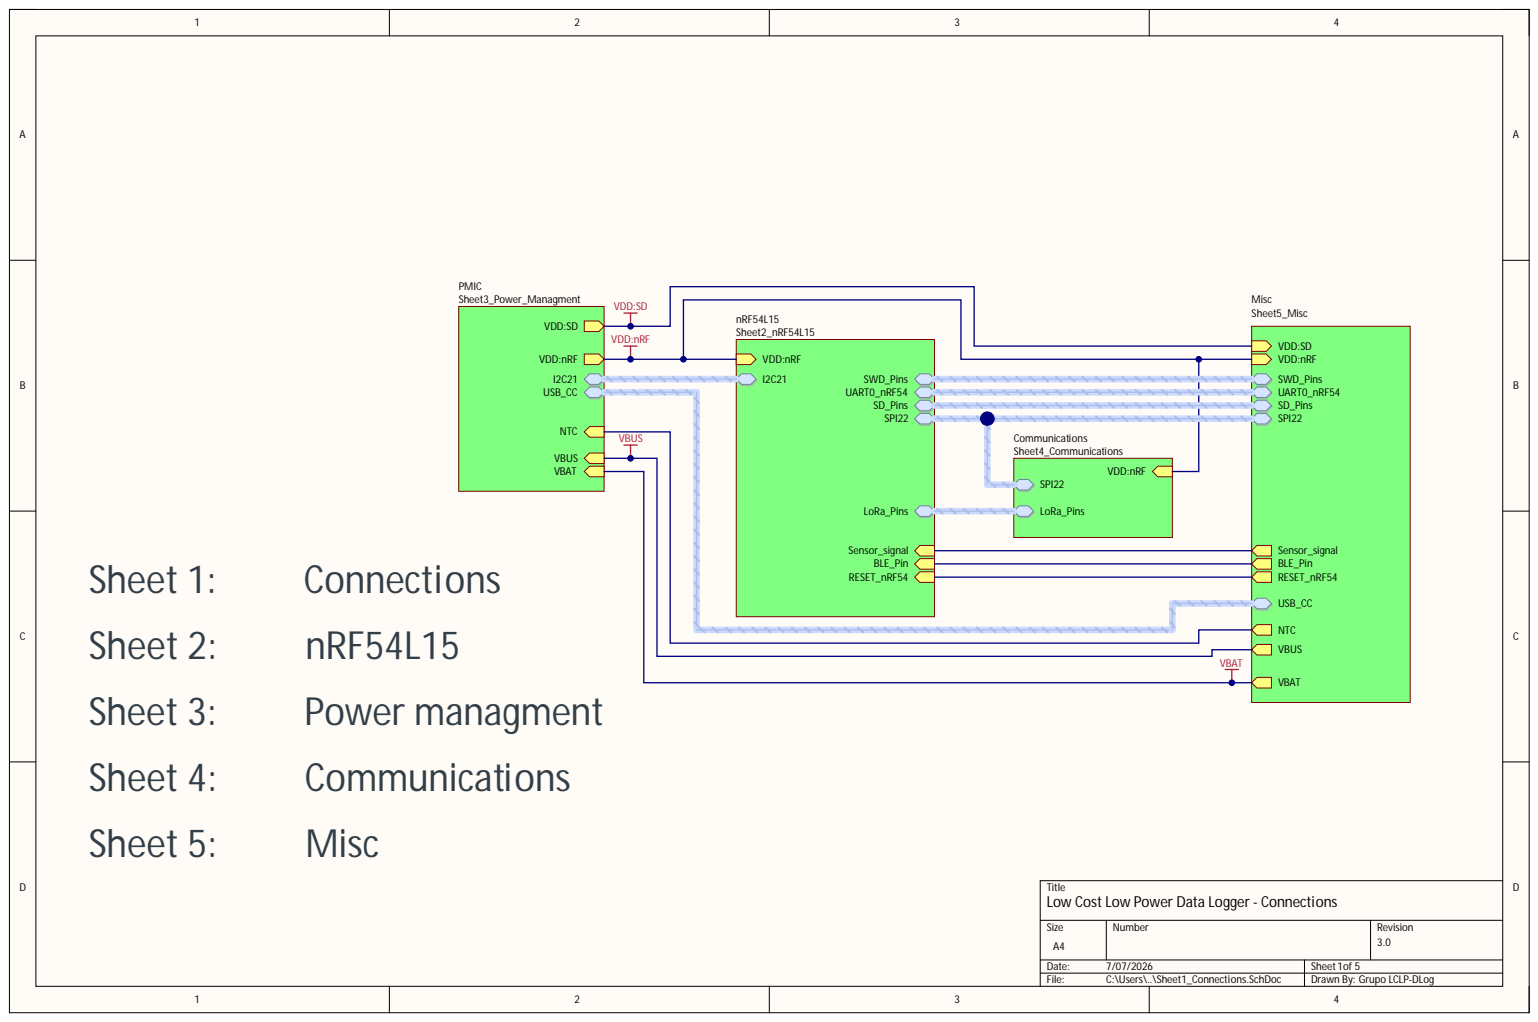
[picture p26: page 1]

Title
Low Cost Low Power Data Logger - Connections

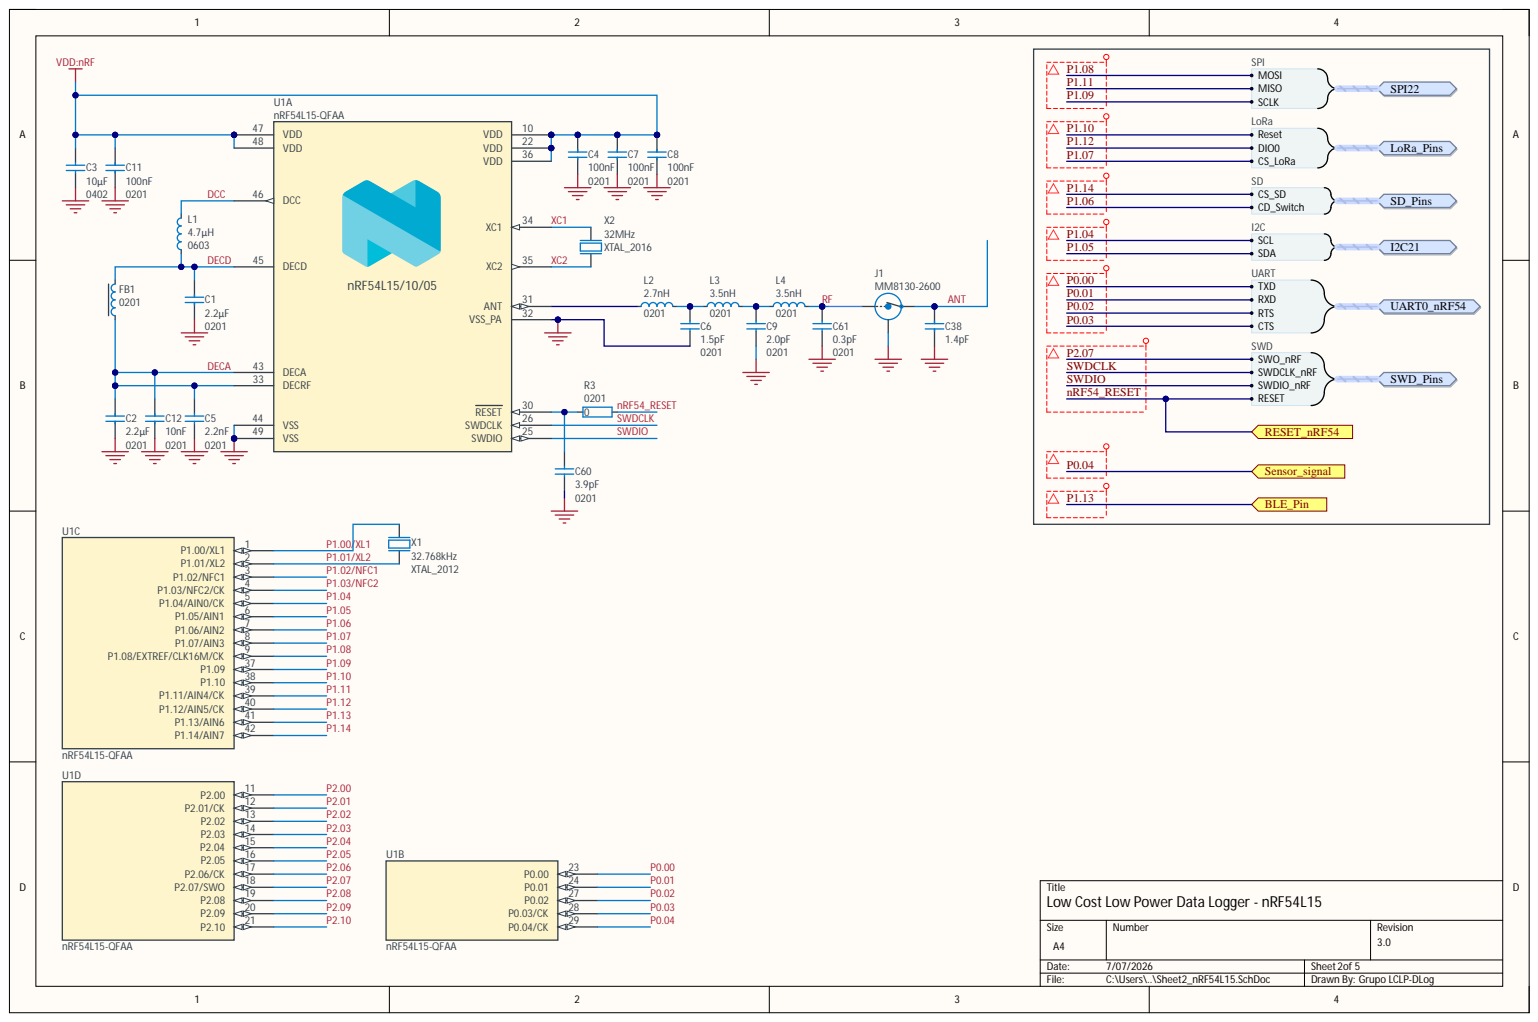
[picture p27: page 2]

DECA 43
DECRF 33

Low Cost Low Power Da

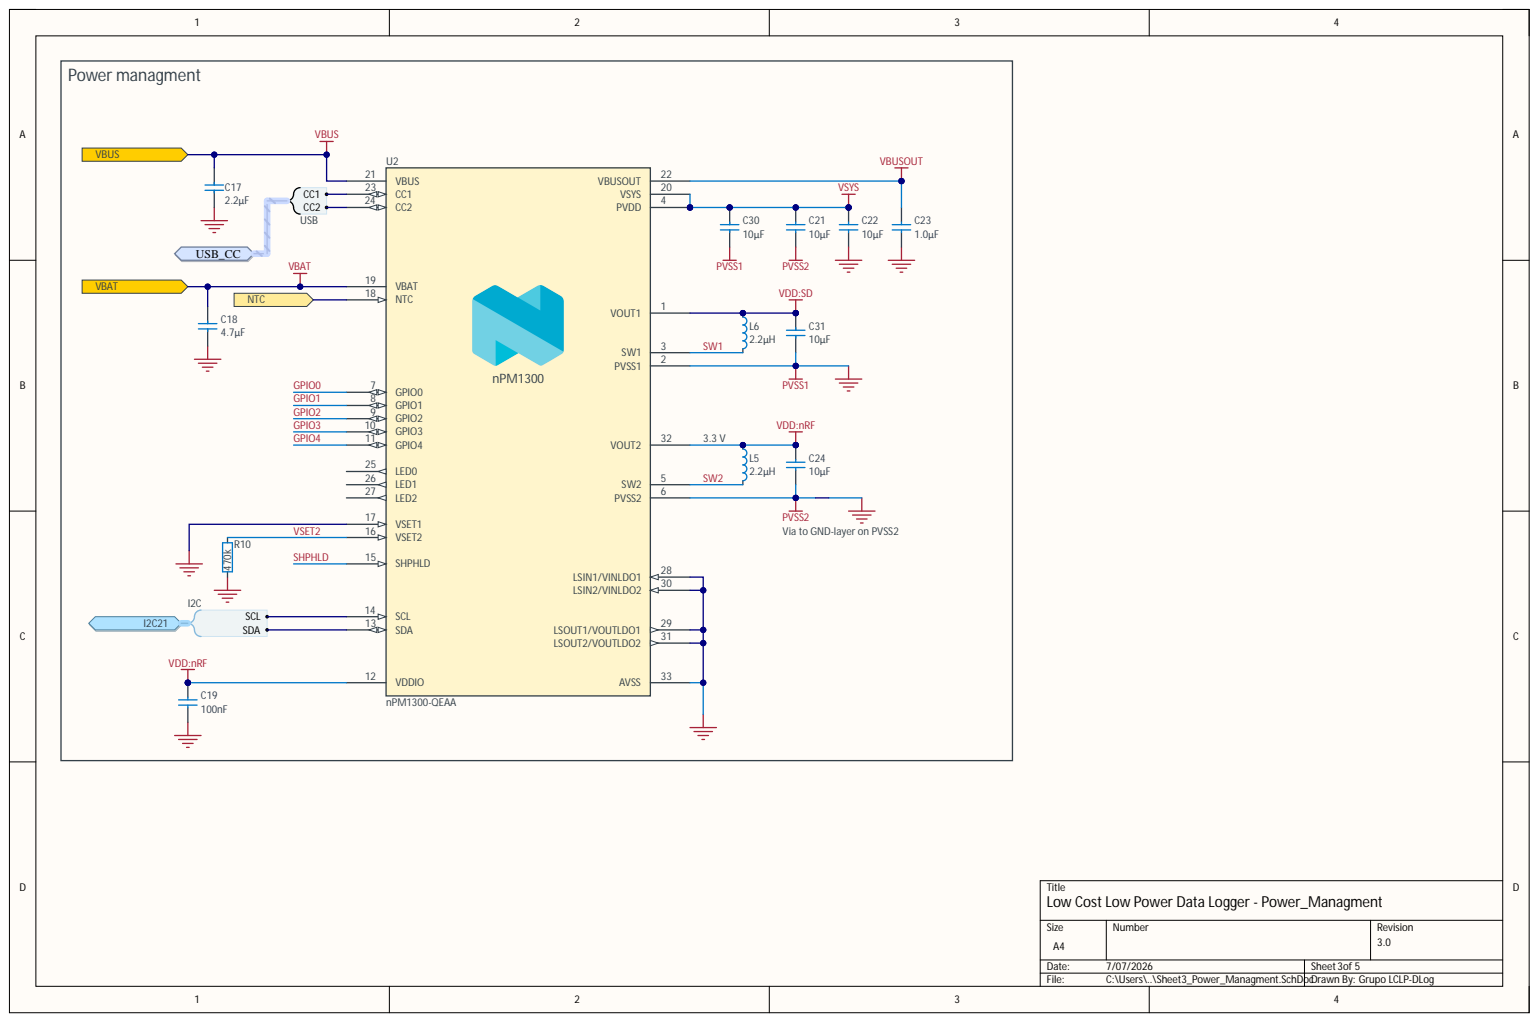
[picture p28: page 3]

VBAT | CC1 23 | VSYS

PVSS2
Via to GND-layer on PVSS2

VSET 2

Low Cost Low Power Da

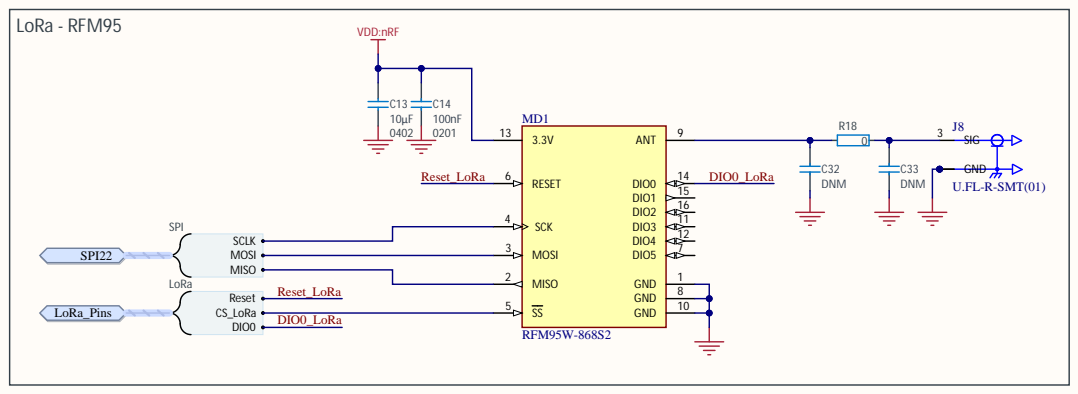
[picture p29: page 4]

Low Cost Low Power Da

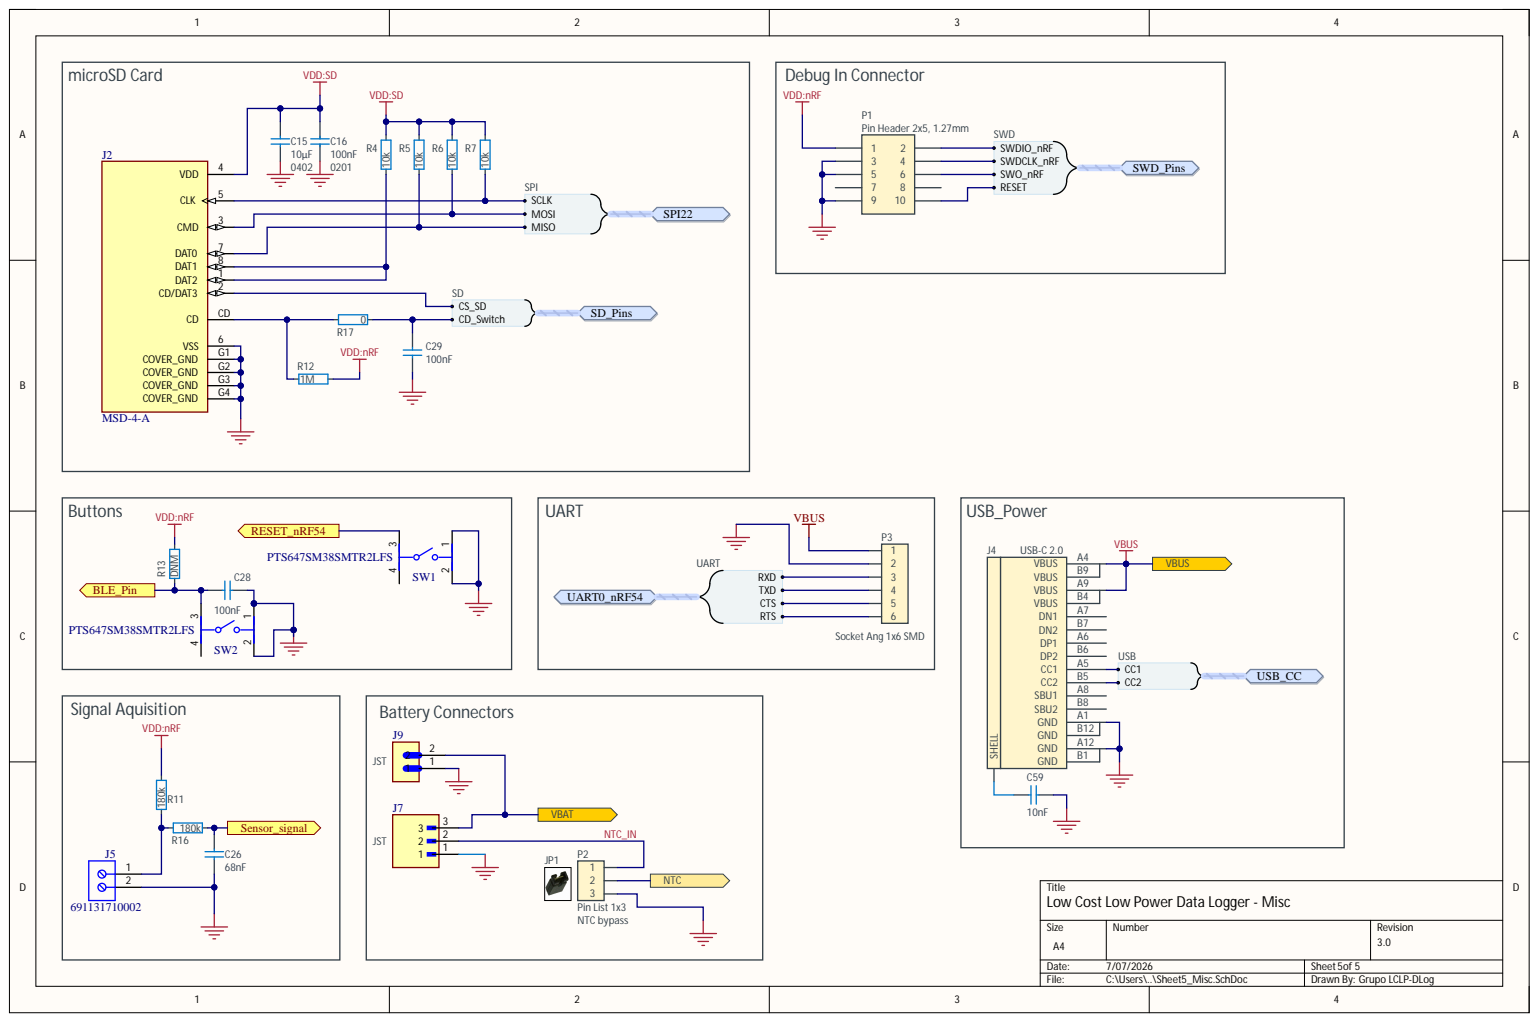
[picture p30: page 5]

Title
Low Cost Low Power Data Logger - Misc

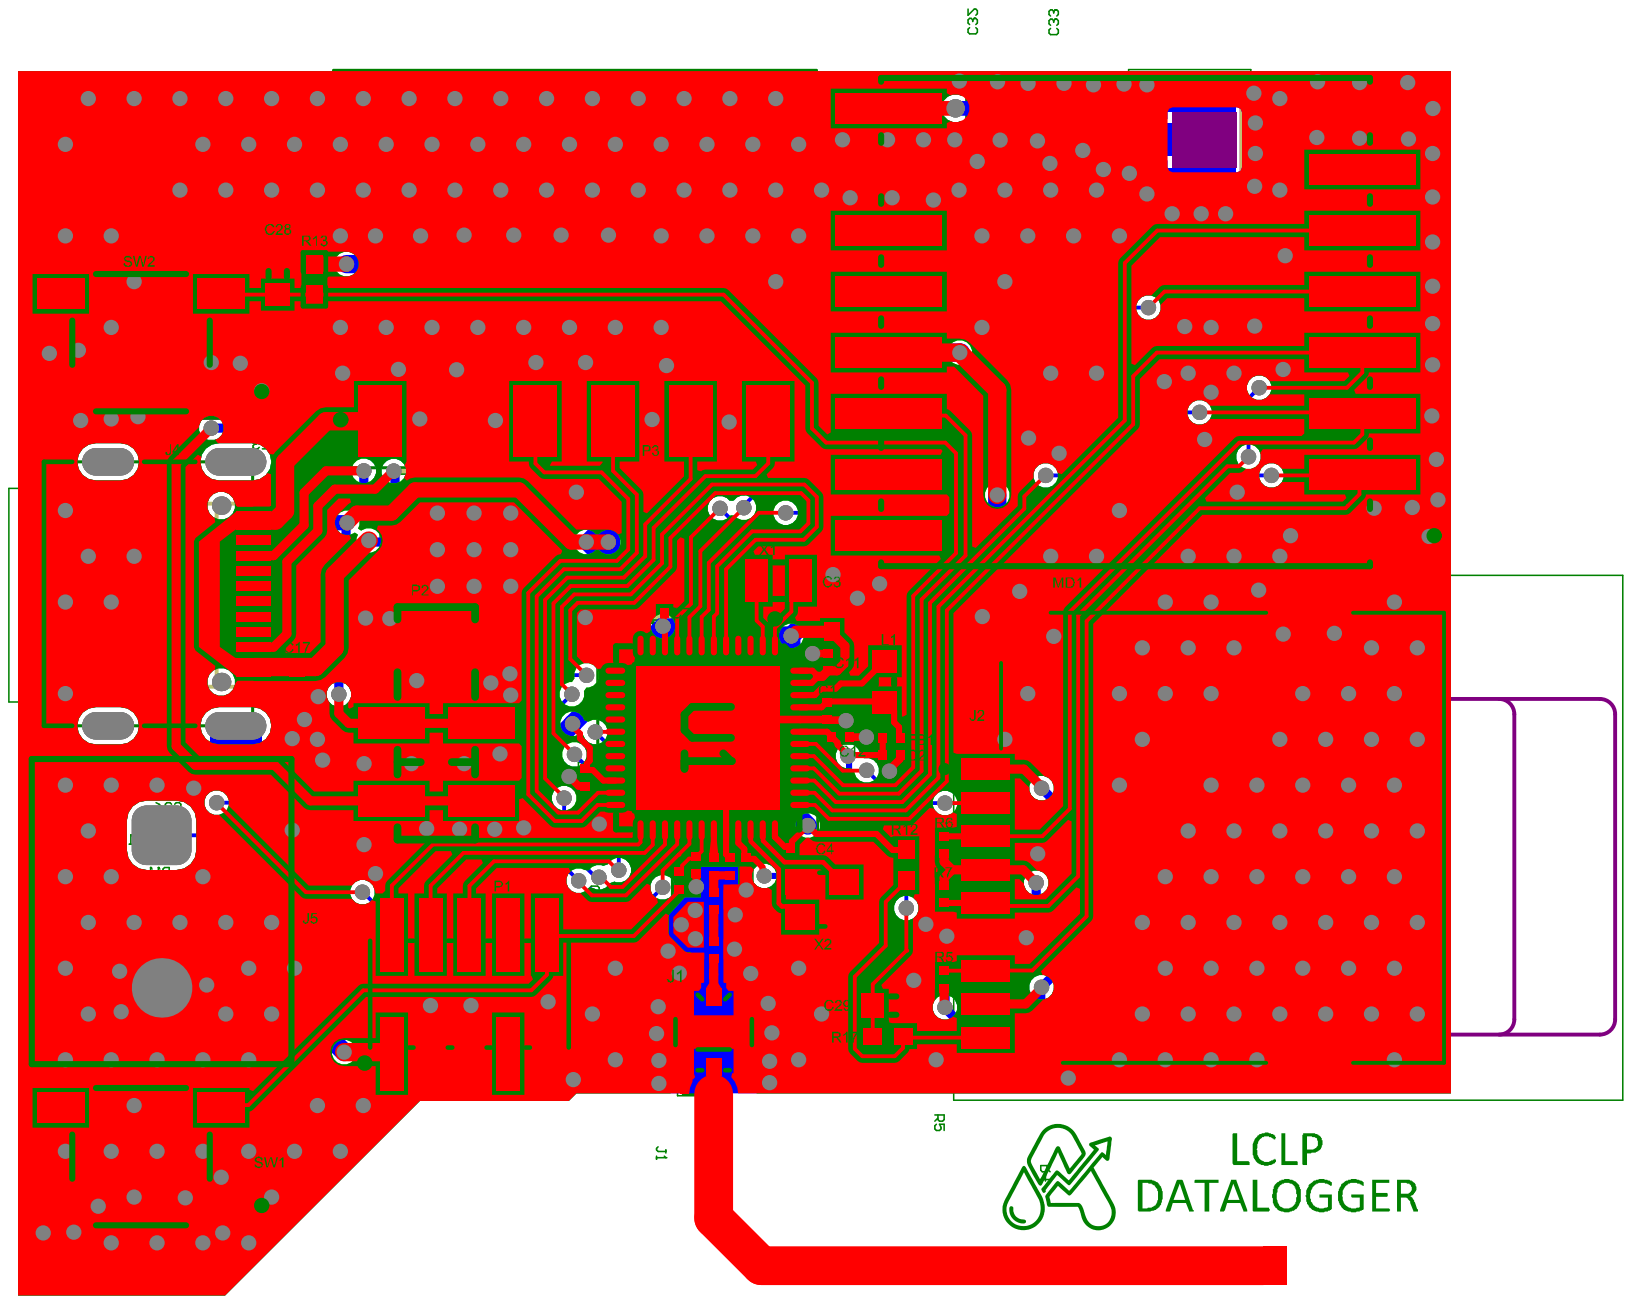
[picture p31: page 6]
