TiagoTavares005/LCLP_DLog/(list of files, drawings)

Other design files:
PCB/PCB_Revisionada/LCLP_DLog_Revisionado/LCLP_DLog_Revisionado.PrjPcb
PCB/PCB_Revisionada/LCLP_DLog_Revisionado/Sheet1_Connections.SchDoc
PCB/PCB_Revisionada/LCLP_DLog_Revisionado/Sheet2_nRF54L15.SchDoc
PCB/PCB_Revisionada/LCLP_DLog_Revisionado/Sheet4_Communications.SchDoc
PCB/PCB_Revisionada/LCLP_DLog_Revisionado/Sheet5_Misc.SchDoc
PCB/PCBV7/LCLP_DLog_V7/LCLP_DLog_V7.PrjPcb
PCB/PCBV7/LCLP_DLog_V7/Sheet1_Connections.SchDoc
PCB/PCBV7/LCLP_DLog_V7/Sheet2_nRF54L15.SchDoc
PCB/PCBV7/LCLP_DLog_V7/Sheet3_Power_Managment.SchDoc
PCB/PCBV7/LCLP_DLog_V7/Sheet4_Communications.SchDoc
PCB/PCBV7/LCLP_DLog_V7/Sheet5_Misc.SchDoc
