TiagoTavares005/LCLP_DLog/(commit log)

2026-07-13 Create PCB
2026-07-13 Update Readme with PCB version information
    Add description of PCB versions in the Readme file
2026-07-13 PCB files
    [LCLP_DLog_Revisionado.PrjPcb, Sheet1_Connections.SchDoc, Sheet2_nRF54L15.SchDoc, Sheet3_Power_Managment.SchDoc, Sheet4_Communications.SchDoc, Sheet5_Misc.SchDoc]
2026-07-13 PCB esquematico
2026-07-13 Adiciona pasta firmware_datalogger_estudos (sem arquivos >100MB)
    [Contagens_30abr.csv, Contagens__new.csv]
